vanceb/gauge/gauge_servo.kicad_pcb

## KiCad design gauge_servo.kicad_pcb (2022-12-30)

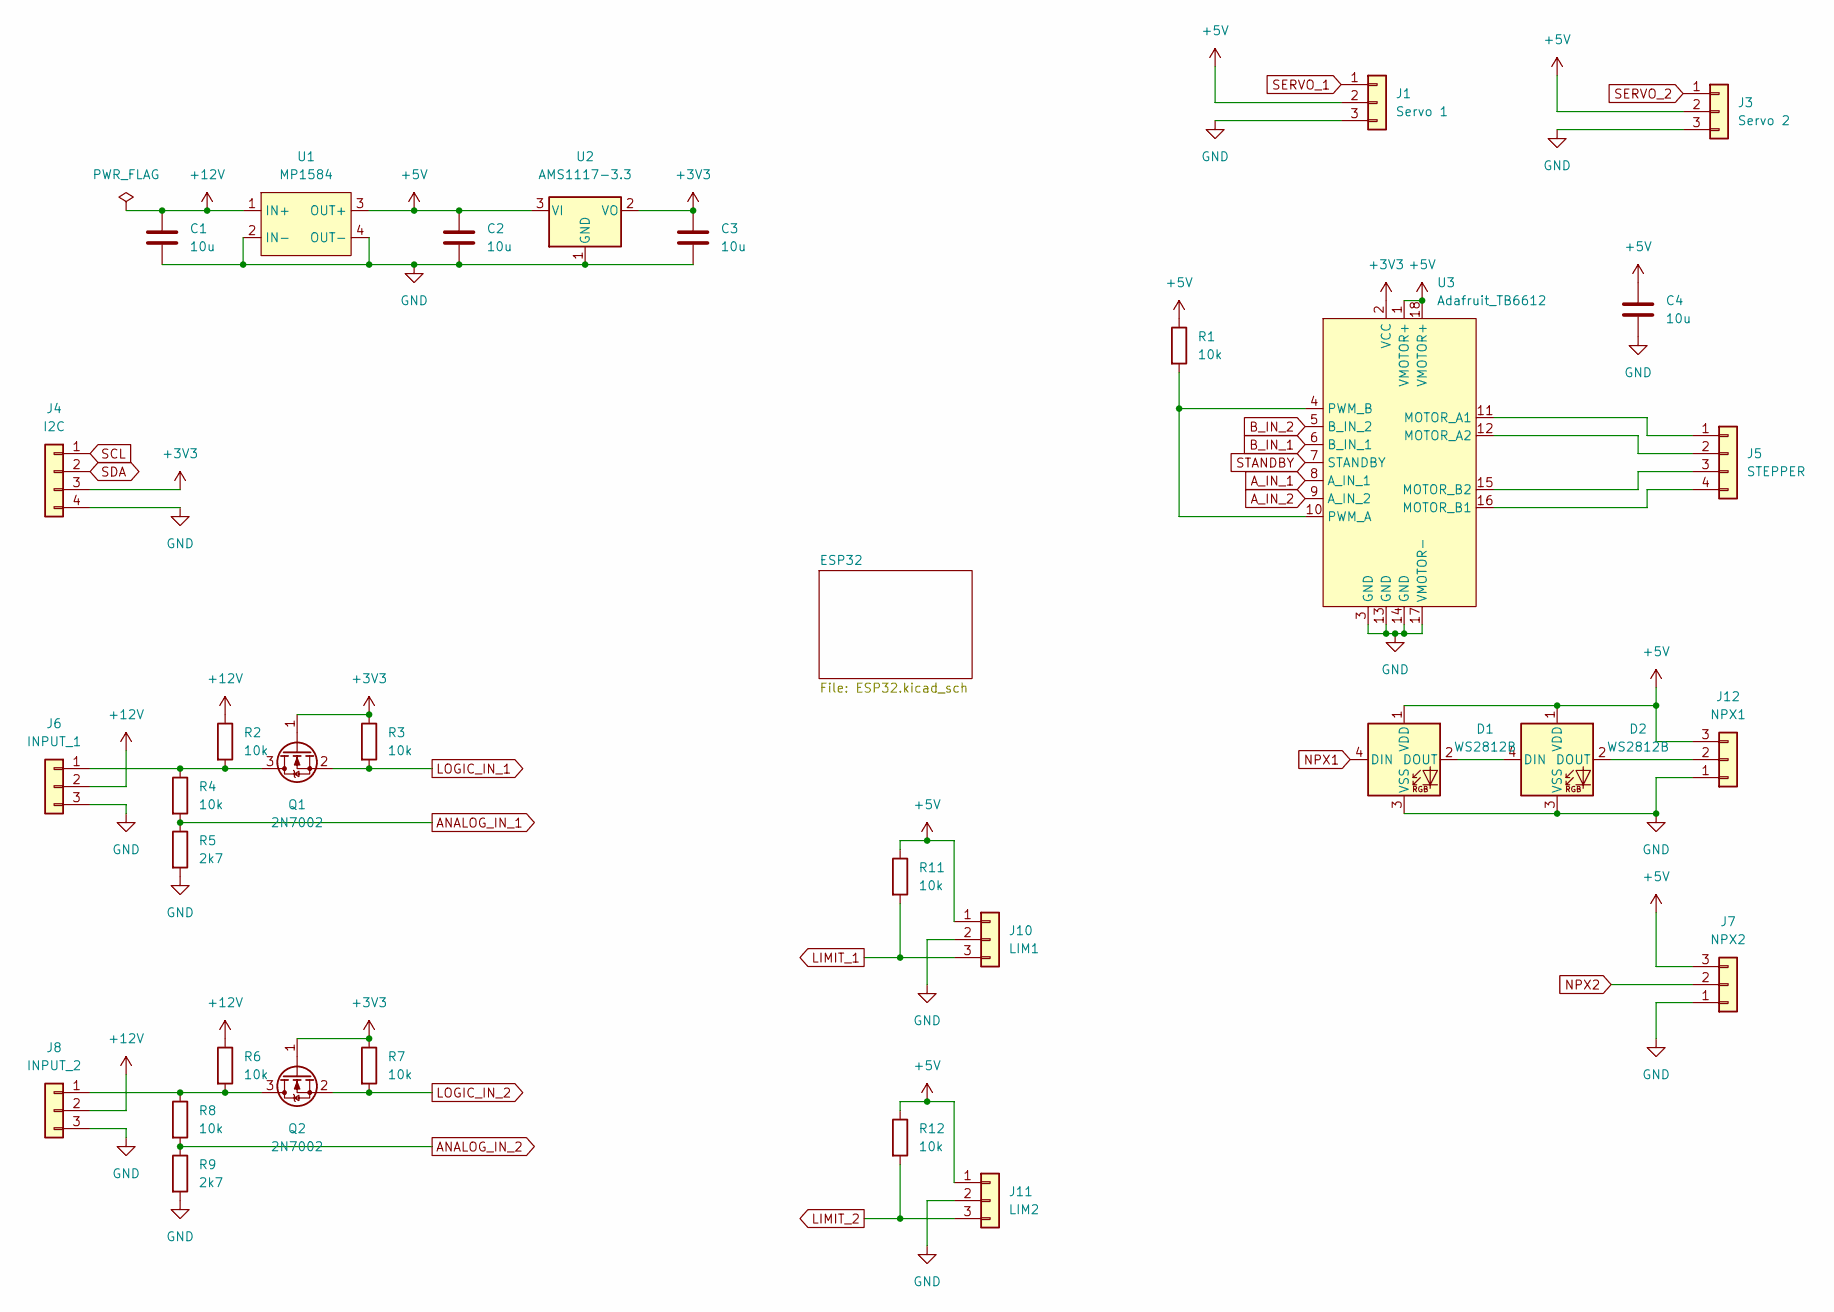
[picture p1: schematic gauge_servo.kicad_sch]

Parts:
C1, C2, C3, C4: 10u; C_1206_3216Metric; LCSC C13585
D1, D2: WS2812B; LED_WS2812B_PLCC4_5.0x5.0mm_P3.2mm
J1: Servo 1; PinHeader_1x03_P2.54mm_Vertical
J3: Servo 2; PinHeader_1x03_P2.54mm_Vertical
J4: I2C; PinHeader_1x04_P2.54mm_Vertical
J5: STEPPER; PinHeader_1x04_P2.54mm_Vertical
J6: INPUT_1; PinHeader_1x03_P2.54mm_Vertical
J7: NPX2; PinHeader_1x03_P2.54mm_Vertical
J8: INPUT_2; PinHeader_1x03_P2.54mm_Vertical
J10: LIM1; PinHeader_1x03_P2.54mm_Vertical
J11: LIM2; PinHeader_1x03_P2.54mm_Vertical
J12: NPX1; PinHeader_1x03_P2.54mm_Vertical
Q1, Q2: 2N7002; SOT-23; LCSC C8545
R1, R2, R3, R4, R6, R7, R8, R11, R12: 10k; R_0603_1608Metric; LCSC C25804
R5, R9: 2k7; R_0603_1608Metric; LCSC C13167
U1: MP1584
U2: AMS1117-3.3; SOT-223-3_TabPin2; LCSC C6186
U3: Adafruit_TB6612

Connections:
+3V3: C3.1, J4.3, Q1.1 (G), Q2.1 (G), R3.1, R7.1, U2.2 (VO), U3.2 (VCC); also elsewhere on the board
+5V: C2.1, C4.1, D1.1 (VDD), D2.1 (VDD), J1.2, J3.2, J7.3, J10.1, J11.1, J12.3, R1.1, R11.1, R12.1, U1.3 (OUT+), U2.3 (VI), U3.1 (VMOTOR+), U3.18 (VMOTOR+)
+12V: C1.1, J6.2, J8.2, R2.1, R6.1, U1.1 (IN+)
ANALOG_IN_1: R4.2, R5.1; also elsewhere on the board
ANALOG_IN_2: R8.2, R9.1; also elsewhere on the board
A_IN_1: U3.8 (A_IN_1); also elsewhere on the board
A_IN_2: U3.9 (A_IN_2); also elsewhere on the board
B_IN_1: U3.6 (B_IN_1); also elsewhere on the board
B_IN_2: U3.5 (B_IN_2); also elsewhere on the board
GND: C1.2, C2.2, C3.2, C4.2, D1.3 (VSS), D2.3 (VSS), J1.3, J3.3, J4.4, J6.3, J7.1, J8.3, J10.2, J11.2, J12.1, R5.2, R9.2, U1.2 (IN-), U1.4 (OUT-), U2.1 (GND), U3.3 (GND), U3.13 (GND), U3.14 (GND), U3.17 (VMOTOR-); also elsewhere on the board
LIMIT_1: J10.3, R11.2; also elsewhere on the board
LIMIT_2: J11.3, R12.2; also elsewhere on the board
LOGIC_IN_1: Q1.2 (S), R3.2; also elsewhere on the board
LOGIC_IN_2: Q2.2 (S), R7.2; also elsewhere on the board
NPX1: D1.4 (DIN); also elsewhere on the board
NPX2: J7.2; also elsewhere on the board
unnamed: D1.2 (DOUT), D2.4 (DIN)
unnamed: D2.2 (DOUT), J12.2
unnamed: J5.1, U3.11 (MOTOR_A1)
unnamed: J5.2, U3.12 (MOTOR_A2)
unnamed: J5.3, U3.15 (MOTOR_B2)
unnamed: J5.4, U3.16 (MOTOR_B1)
unnamed: J6.1, Q1.3 (D), R2.2, R4.1
unnamed: J8.1, Q2.3 (D), R6.2, R8.1
unnamed: R1.2, U3.4 (PWM_B), U3.10 (PWM_A)
SCL: J4.1; also elsewhere on the board
SDA: J4.2; also elsewhere on the board
SERVO_1: J1.1; also elsewhere on the board
SERVO_2: J3.1; also elsewhere on the board
STANDBY: U3.7 (STANDBY); also elsewhere on the board

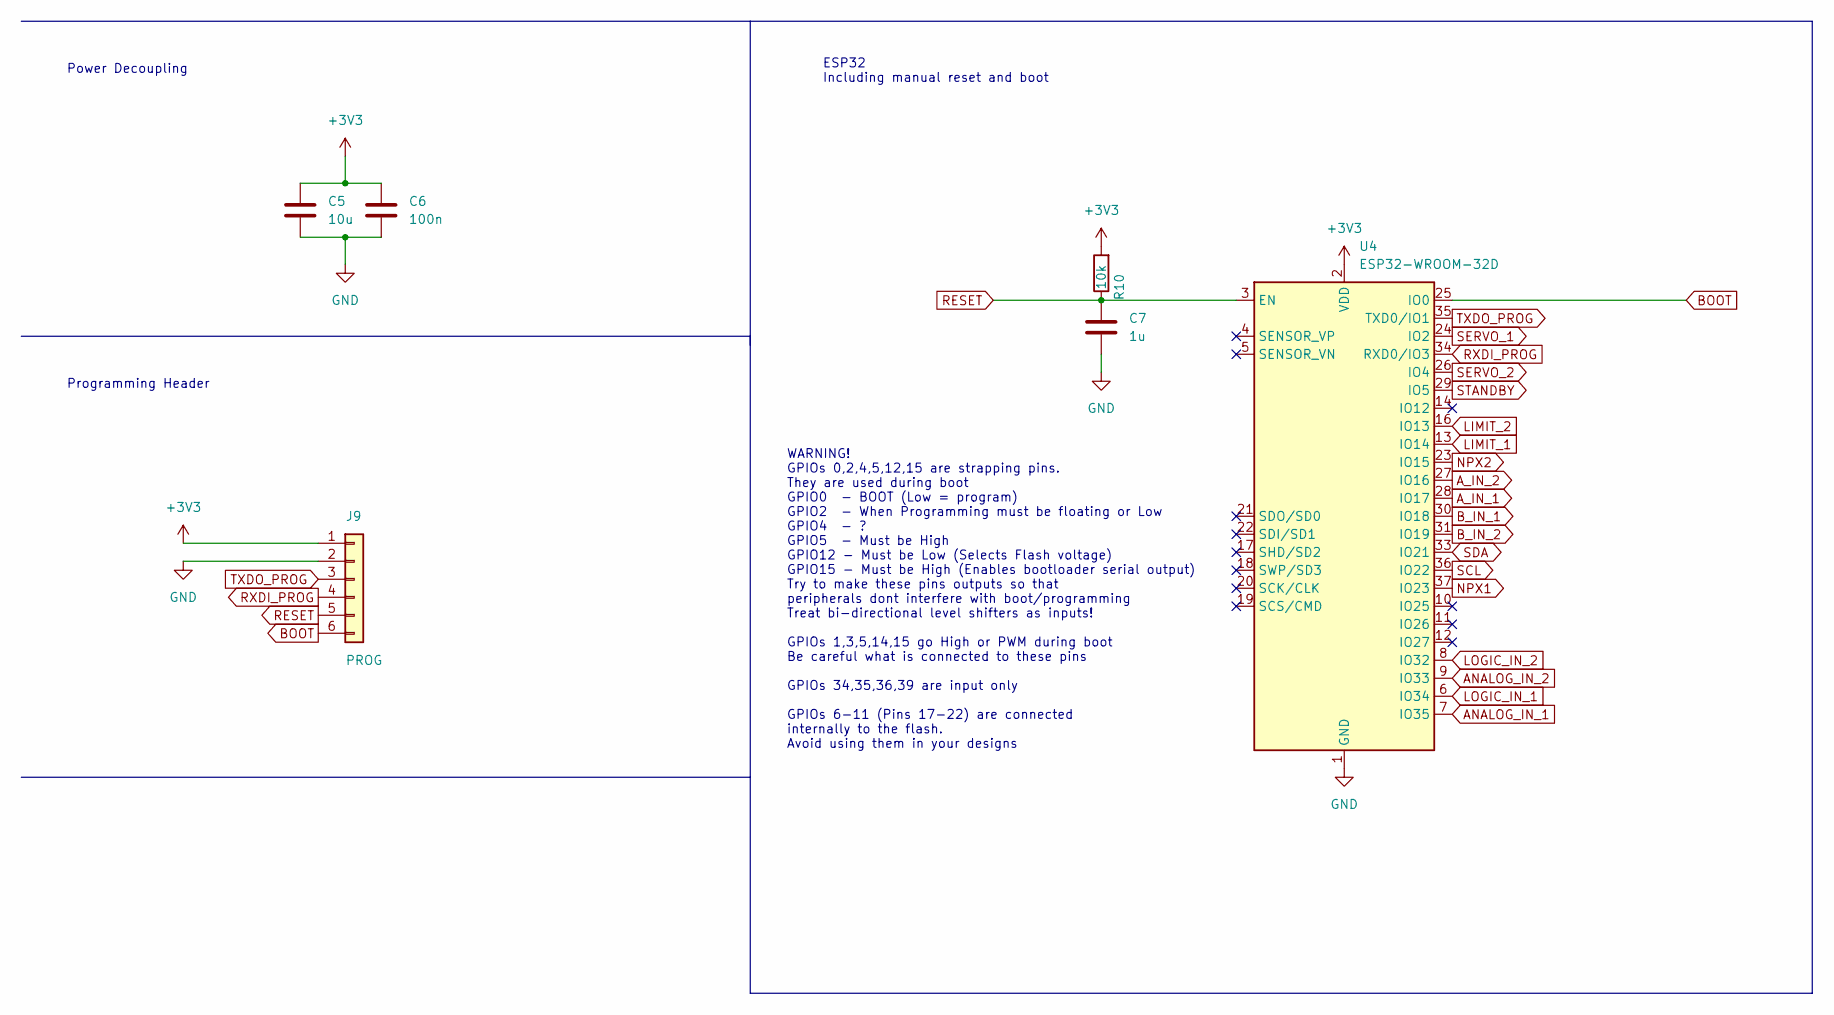
[picture p2: schematic ESP32.kicad_sch]

Parts:
C5: 10u; C_1206_3216Metric; LCSC C13585
C6: 100n; C_0603_1608Metric; LCSC C14663
C7: 1u; C_0603_1608Metric; LCSC C15849
J9: PROG; PinHeader_1x06_P2.54mm_Vertical
R10: 10k; R_0603_1608Metric_Pad0.98x0.95mm_HandSolder; LCSC C25804
U4: ESP32-WROOM-32D; ESP32-WROOM-32; LCSC C473012

Connections:
+3V3: C5.1, C6.1, J9.1, R10.2, U4.2 (VDD); also elsewhere on the board
ANALOG_IN_1: U4.7 (IO35); also elsewhere on the board
ANALOG_IN_2: U4.9 (IO33); also elsewhere on the board
A_IN_1: U4.28 (IO17); also elsewhere on the board
A_IN_2: U4.27 (IO16); also elsewhere on the board
BOOT: J9.6, U4.25 (IO0)
B_IN_1: U4.30 (IO18); also elsewhere on the board
B_IN_2: U4.31 (IO19); also elsewhere on the board
GND: C5.2, C6.2, C7.2, J9.2, U4.1 (GND), U4.15 (GND), U4.38 (GND), U4.39 (GND); also elsewhere on the board
LIMIT_1: U4.13 (IO14); also elsewhere on the board
LIMIT_2: U4.16 (IO13); also elsewhere on the board
LOGIC_IN_1: U4.6 (IO34); also elsewhere on the board
LOGIC_IN_2: U4.8 (IO32); also elsewhere on the board
NPX1: U4.37 (IO23); also elsewhere on the board
NPX2: U4.23 (IO15); also elsewhere on the board
RESET: C7.1, J9.5, R10.1, U4.3 (EN)
RXDI_PROG: J9.4, U4.34 (RXD0/IO3)
SCL: U4.36 (IO22); also elsewhere on the board
SDA: U4.33 (IO21); also elsewhere on the board
SERVO_1: U4.24 (IO2); also elsewhere on the board
SERVO_2: U4.26 (IO4); also elsewhere on the board
STANDBY: U4.29 (IO5); also elsewhere on the board
TXDO_PROG: J9.3, U4.35 (TXD0/IO1)

Notes on the sheet:
ESP32 Including manual reset and boot
Programming Header
WARNING! GPIOs 0,2,4,5,12,15 are strapping pins. They are used during boot GPIO0 - BOOT (Low = program) GPIO2 - When Programming must be floating or Low GPIO4 - ? GPIO5 - Must be High GPIO12 - Must be Low (Selects Flash voltage) GPIO15 - Must be High (Enables bootloader serial output) Try to make t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
Power Decoupling

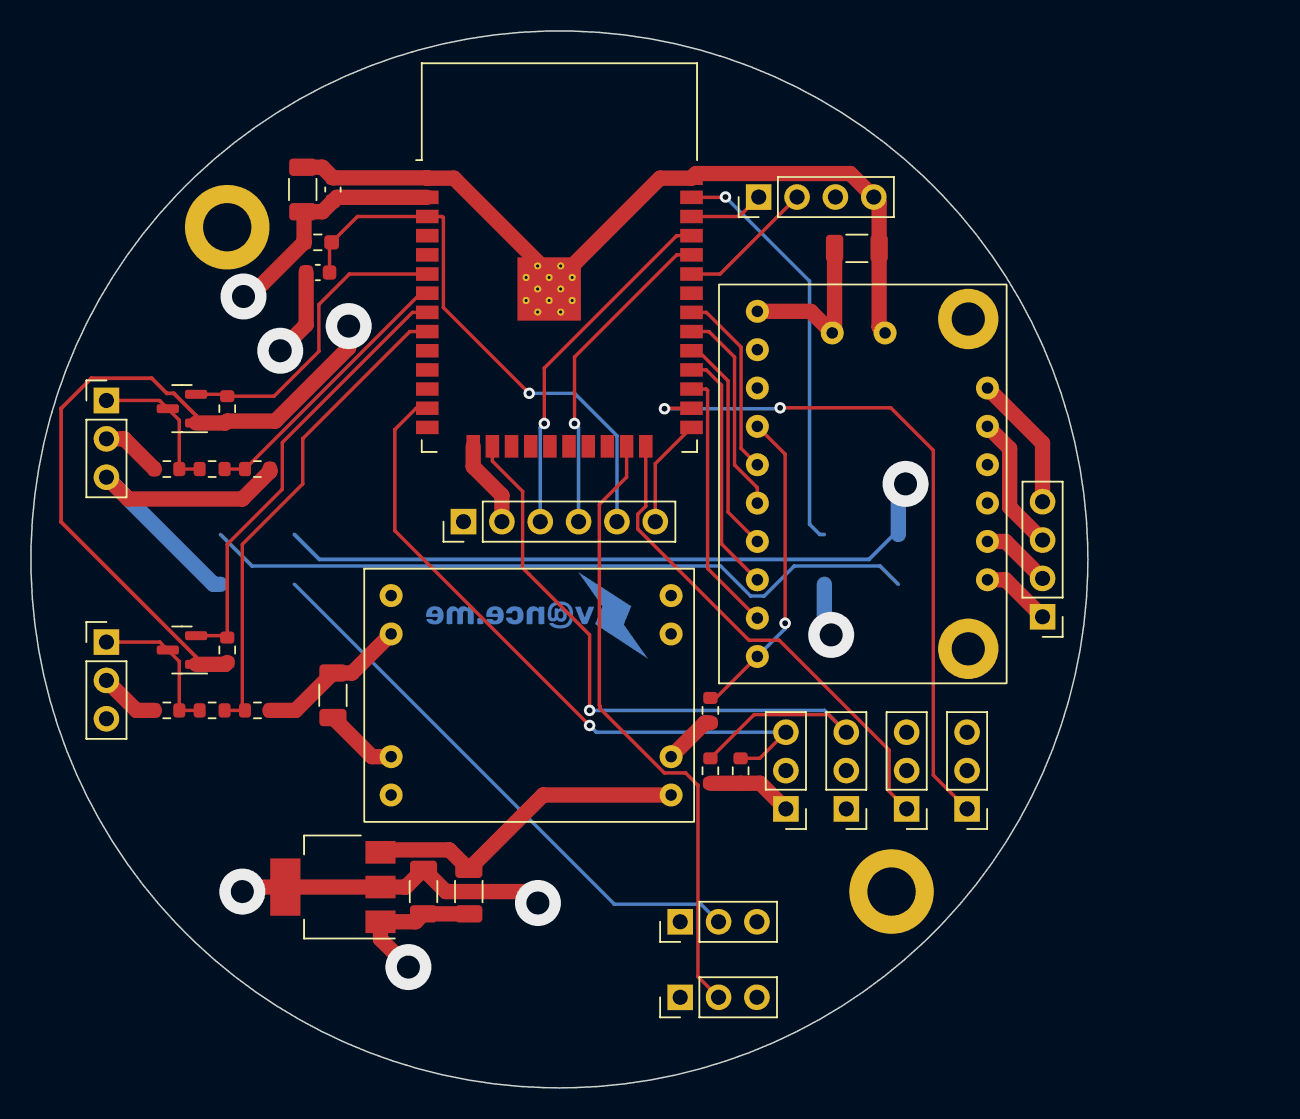
[picture p3: board gauge_servo.kicad_pcb from above]

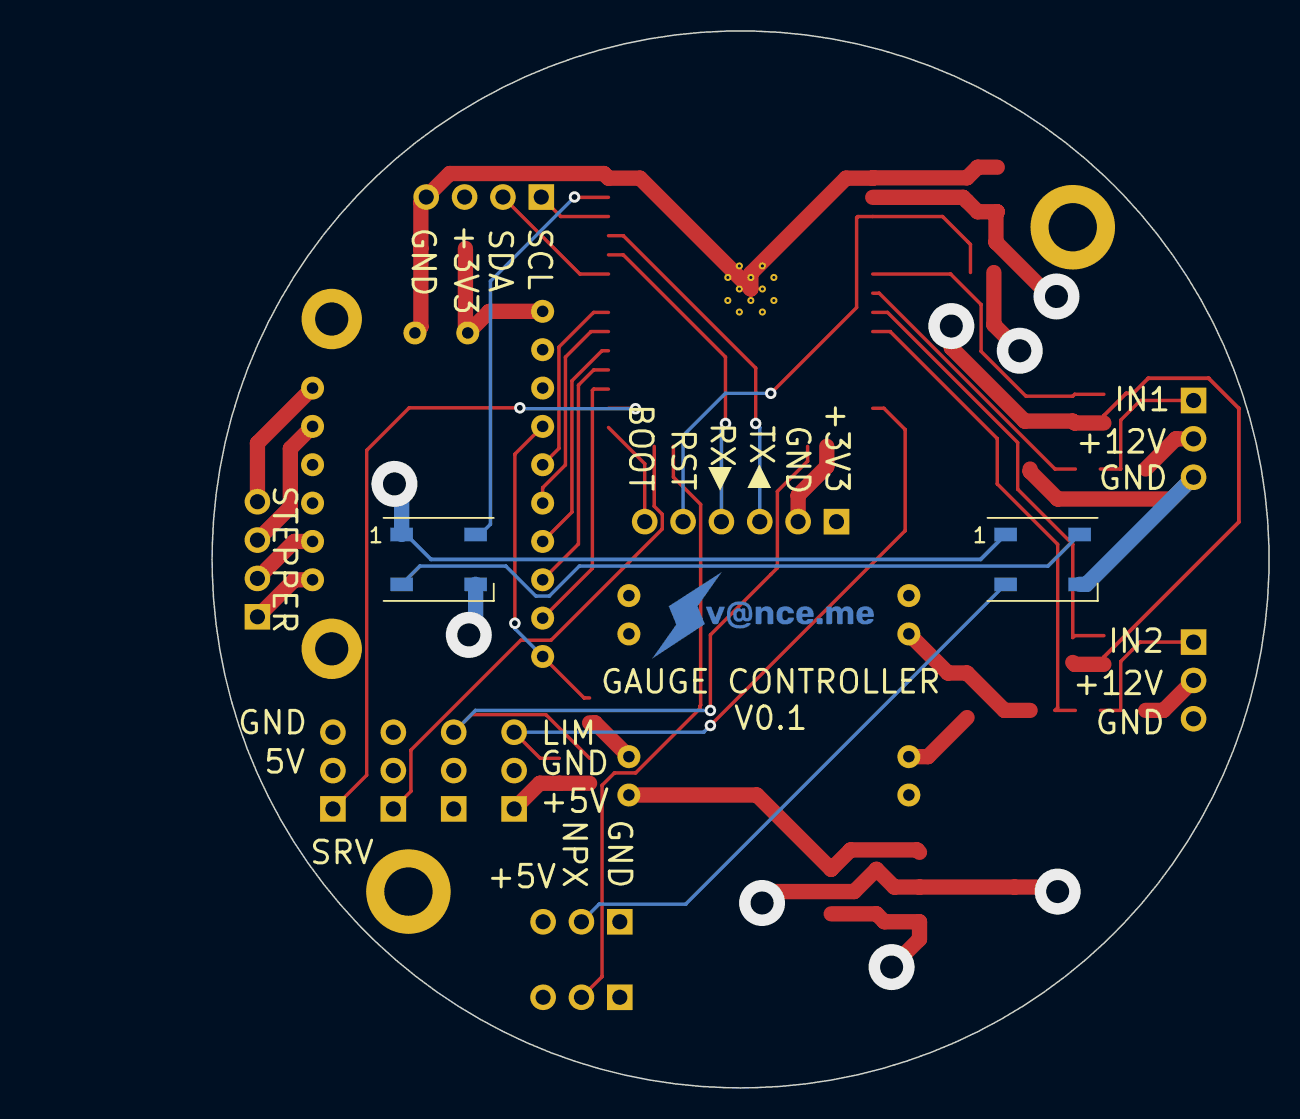
[picture p4: board gauge_servo.kicad_pcb from below]

Board: 4 copper layers, 70.0 x 70.0 mm, 38 parts (2 on the bottom side), 34 nets.
