vanceb/gauge/(commit log)

2022-12-19 v0.1 production files
    [gauge_servo-CmtUser.gbr, gauge_servo-CuBottom.gbl, gauge_servo-CuTop.gtl, gauge_servo-EdgeCuts.gm1, gauge_servo-MaskBottom.gbs, gauge_servo-MaskTop.gts, gauge_servo-PasteBottom.gbp, gauge_servo-PasteTop.gtp]
2022-12-30 Fixed pinout error or Adafruit TB6612 custom component that caused short between 5V and gnd
    [ESP32.kicad_sch, gauge_servo.kicad_pcb, gauge_servo.kicad_sch]
2022-12-30 Moved LIMIT1 signal away from IO12 where the pullup was stopping the ESP from booting
    [ESP32.kicad_sch, gauge_servo.kicad_pcb, gauge_servo.kicad_sch]
